bulicp/FRI-ESP32-PCB-workshop/book/src/app-b-01-capacitance.md

# B.1 Capacitance

Match the value called for by the datasheet or your calculation. Going *higher* is usually safe for bulk and decoupling capacitors; going *lower* than a specified value can break stability, as with the LDO in section 2.8.
