bulicp/FRI-ESP32-PCB-workshop/book/src/SUMMARY.md

# Summary

[Introduction](intro.md)

- [0. What we are building](00-what-we-are-building.md)
  - [Signal assignment](00-01-signal-assignment.md)
- [1. Vocabulary](01-vocabulary.md)
- [2. The schematic](02-the-schematic.md)
  - [2.1 What a schematic is, and what it is not](02-01-what-a-schematic-is-and-what-it-is-not.md)
  - [2.2 The power chain](02-02-the-power-chain.md)
  - [2.3 The USB-C receptacle](02-03-the-usb-c-receptacle.md)
  - [2.4 Why the receptacle has D+/D− in two places](02-04-why-the-receptacle-has-d-d-in-two-places.md)
  - [2.5 CC1 / CC2 — why exactly 5.1 kΩ](02-05-cc1-cc2-why-exactly-5-1-k.md)
  - [2.6 ESD protection, twice](02-06-esd-protection-twice.md)
  - [2.7 The LDO regulator](02-07-the-ldo-regulator.md)
  - [2.8 Regulator capacitors — do not improvise these values](02-08-regulator-capacitors-do-not-improvise-these-values.md)
  - [2.9 The module and its decoupling](02-09-the-module-and-its-decoupling.md)
  - [2.10 Buttons, strapping pins and the boot sequence](02-10-buttons-strapping-pins-and-the-boot-sequence.md)
  - [2.11 LEDs and the active-low trap](02-11-leds-and-the-active-low-trap.md)
  - [2.12 Breakout headers, and why the board is not a finished product](02-12-breakout-headers-and-why-the-board-is-not-a-finish.md)
  - [2.13 Schematic grouping and PWR_FLAG](02-13-schematic-grouping-and-pwr-flag.md)
  - [2.14 ERC](02-14-erc.md)
- [3. Footprints and board outline](03-footprints-and-board-outline.md)
  - [3.1 Footprints: where logic meets physics](03-01-footprints-where-logic-meets-physics.md)
  - [3.2 Package families: through-hole and surface mount](03-02-package-families-through-hole-and-surface-mount.md)
  - [3.3 Package sizes: 0402 vs 0603 vs 0805](03-03-package-sizes-0402-vs-0603-vs-0805.md)
  - [3.4 Board outline](03-04-board-outline.md)
- [4. Layers and placement](04-layers-and-placement.md)
  - [4.1 Placement strategy](04-01-placement-strategy.md)
  - [4.2 Why four layers](04-02-why-four-layers.md)
  - [4.3 Two islands on one layer, and zone priority](04-03-two-islands-on-one-layer-and-zone-priority.md)
  - [4.4 Vias: connecting pins, layers and planes](04-04-vias-connecting-pins-layers-and-planes.md)
- [5. Routing](05-routing.md)
  - [5.1 Net classes](05-01-net-classes.md)
  - [5.2 Differential pair routing](05-02-differential-pair-routing.md)
  - [5.3 Routing order](05-03-routing-order.md)
  - [5.4 Pours and stitching vias](05-04-pours-and-stitching-vias.md)
  - [5.5 DRC](05-05-drc.md)
- [6. Manufacturing outputs](06-manufacturing-outputs.md)
  - [6.1 What the fabricator receives](06-01-what-the-fabricator-receives.md)
  - [6.2 Export](06-02-export.md)
  - [6.3 Look at what you are sending](06-03-look-at-what-you-are-sending.md)
  - [6.4 The BOM](06-04-the-bom.md)
  - [6.5 DFM: talking to the fabricator](06-05-dfm-talking-to-the-fabricator.md)
- [7. Bringing the board up](07-bringing-the-board-up.md)
  - [7.1 Before plugging in USB](07-01-before-plugging-in-usb.md)
  - [7.2 Sequence](07-02-sequence.md)
  - [7.3 First program](07-03-first-program.md)
- [Appendix A: Common mistakes](app-a-common-mistakes.md)
- [Appendix B: How to select a capacitor](app-b-how-to-select-a-capacitor.md)
  - [B.1 Capacitance](app-b-01-capacitance.md)
  - [B.2 Voltage rating — and why to derate](app-b-02-voltage-rating-and-why-to-derate.md)
  - [B.3 Dielectric class](app-b-03-dielectric-class.md)
  - [B.4 Checklist before adding a part to the BOM](app-b-04-checklist-before-adding-a-part-to-the-bom.md)
- [Appendix C: Bill of materials](app-c-bill-of-materials.md)
- [Appendix D: Where to go next](app-d-where-to-go-next.md)
- [Appendix E: Reference material](app-e-reference-material.md)
