bulicp/FRI-ESP32-PCB-workshop/book/src/images/esd-protection.png

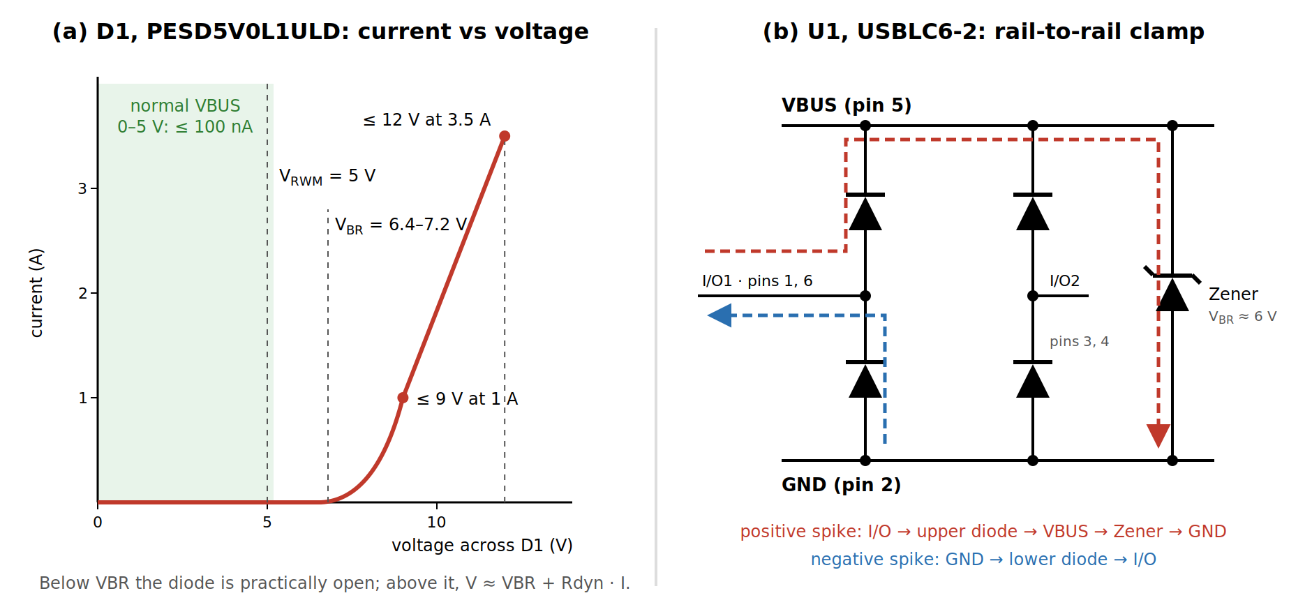
book/src/images/esd-protection.png
