bulicp/FRI-ESP32-PCB-workshop/book/src/images/ldo-block.png

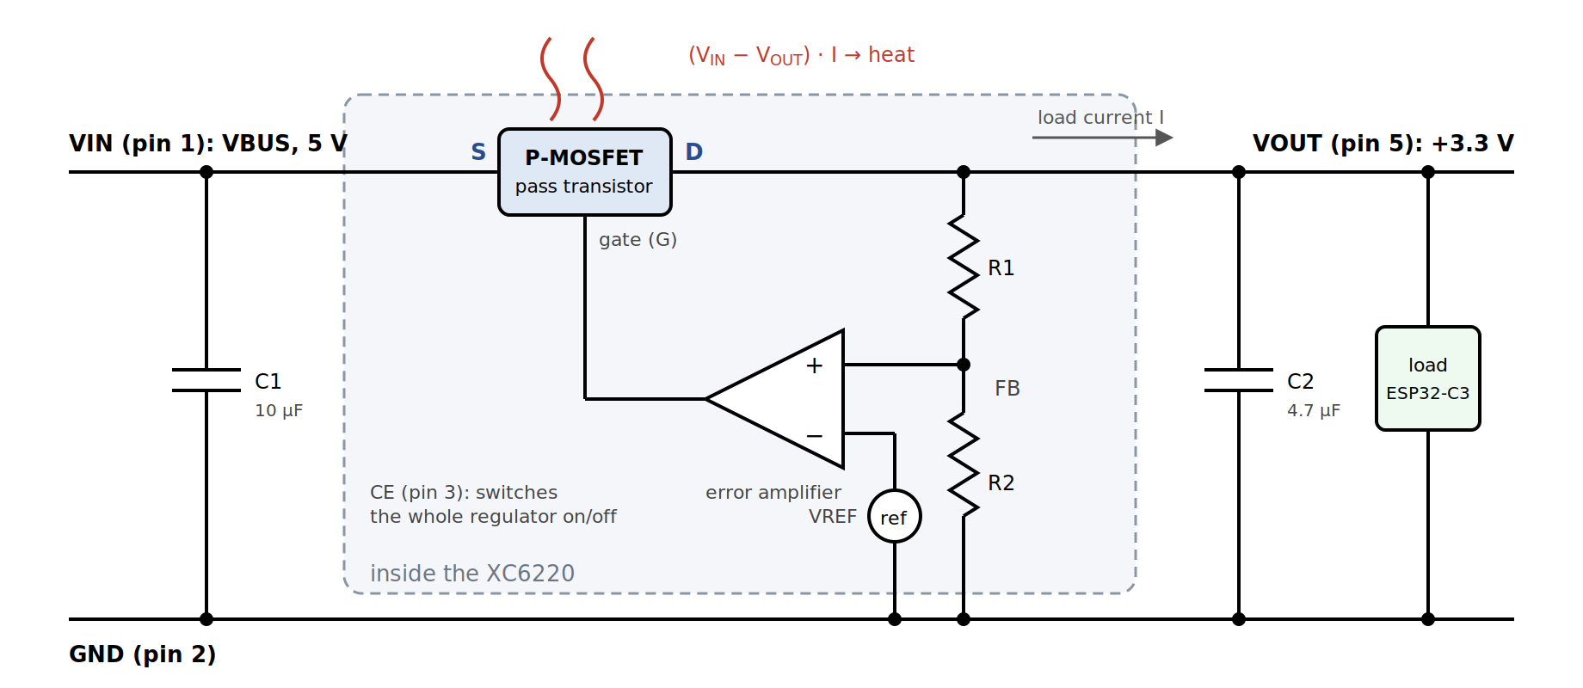
book/src/images/ldo-block.png
