bulicp/FRI-ESP32-PCB-workshop/book/src/images/packages.png

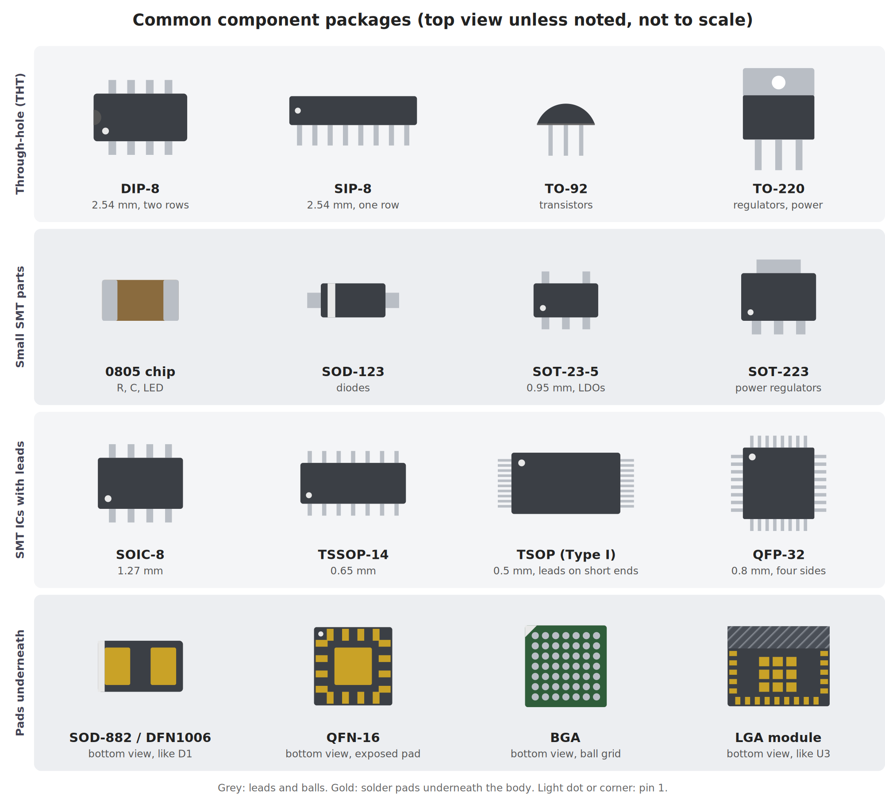
book/src/images/packages.png
