bulicp/FRI-ESP32-PCB-workshop/book/src/images/usb-c-cc-divider 2.png

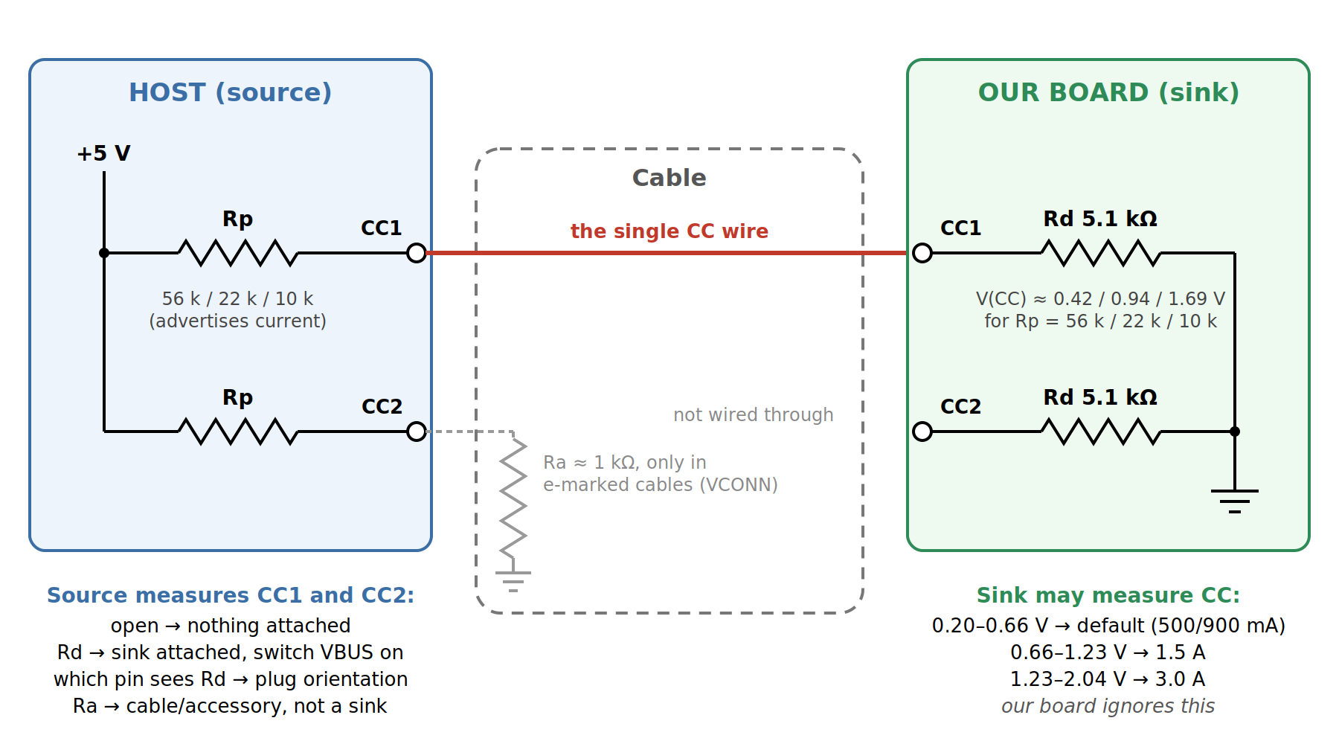
book/src/images/usb-c-cc-divider 2.png
