bulicp/FRI-ESP32-PCB-workshop/book/src/app-b-04-checklist-before-adding-a-part-to-the-bom.md

# B.4 Checklist before adding a part to the BOM

1. Capacitance meets or exceeds the requirement
2. Voltage rating ≥ 2× the working voltage
3. Dielectric is X5R or X7R
4. Package matches the intended assembly method
