bulicp/FRI-ESP32-PCB-workshop/book/src/app-e-reference-material.md

# Appendix E: Reference material

| Document | Source |
|---|---|
| ESP32-C3-MINI-1 & MINI-1U Datasheet v2.2 | Espressif — pinout, boot configuration, land pattern |
| ESP32-C3 Technical Reference Manual | Espressif |
| ESP Hardware Design Guidelines — PCB Layout | Espressif — stackup and power-plane principles |
| XC6220 series datasheet | Torex — the C<sub>IN</sub>/C<sub>L</sub> compensation table |
| USBLC6-2SC6 datasheet | STMicroelectronics |
| PESD5V0L1ULD datasheet | Nexperia |
| KiCad documentation | docs.kicad.org |
