bulicp/FRI-ESP32-PCB-workshop/book/src/app-b-how-to-select-a-capacitor.md

# Appendix B: How to select a capacitor

Beyond the nominal value, three parameters matter.
