bulicp/FRI-ESP32-PCB-workshop/03-powerzones/FRI-ESP32.kicad_pcb

## KiCad design 03-powerzones/FRI-ESP32.kicad_pcb (2026-09-26)

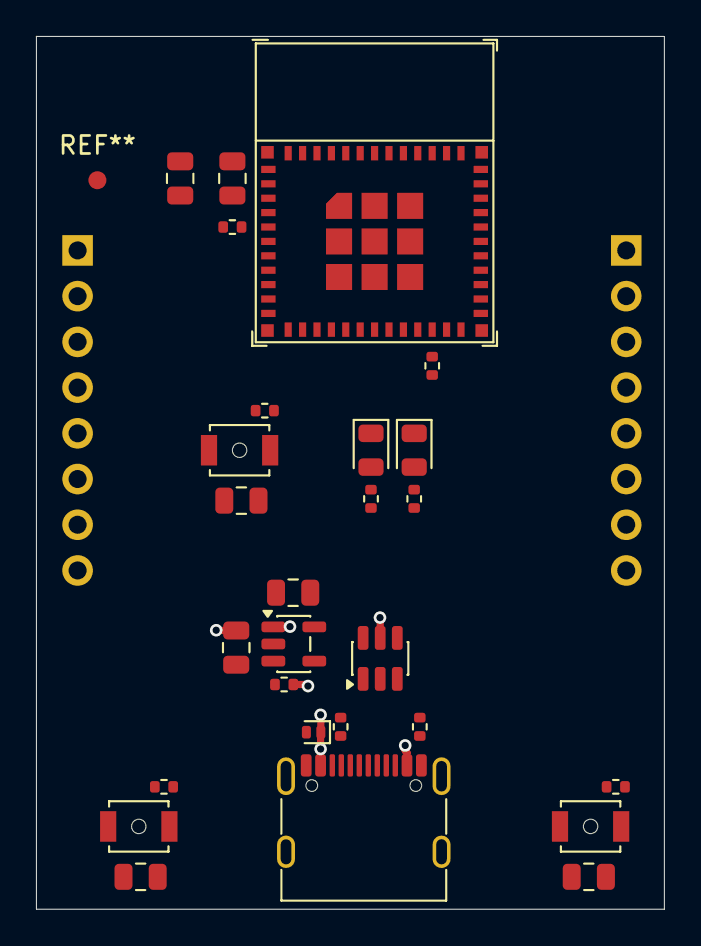
[picture p24: board 03-powerzones/FRI-ESP32.kicad_pcb from above]

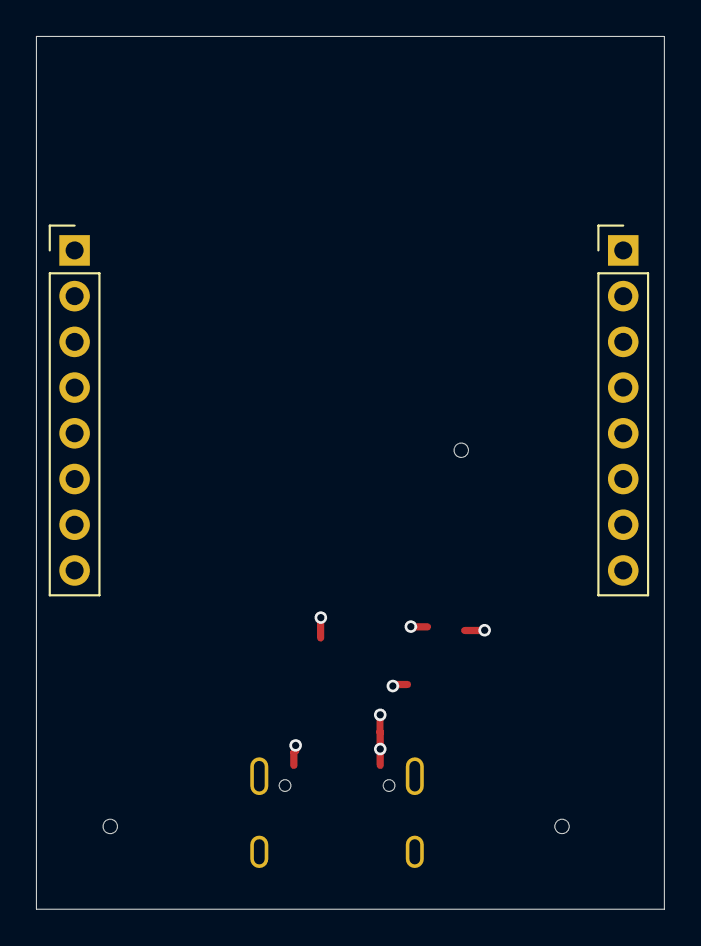
[picture p25: board 03-powerzones/FRI-ESP32.kicad_pcb from below]

Board: 4 copper layers, 34.9 x 48.5 mm, 29 parts (2 on the bottom side), 26 nets.

Parts:
BOOT1: SW_Push; SW_SPST_B3U-1000P-B
C1, C7: 10uF; C_0805_2012Metric
C2: 4.7uF; C_0805_2012Metric
C3, C4, C5, C6: 100nF; C_0805_2012Metric
D1: PESD5V0L1ULD; D_SOD-882D
D2: LED GREEN; LED_0805_2012Metric
D3: LED YELLOW; LED_0805_2012Metric
J1: USB_C_Receptacle_USB2.0_16P; USB_C_Receptacle_G-Switch_GT-USB-7010ASV
J2, J3: Conn_01x08; PinHeader_1x08_P2.54mm_Vertical
R1, R2: 5.1K; R_0402_1005Metric
R3: 4.7K; R_0402_1005Metric
R4, R5, R6, R7, R8: 10K; R_0402_1005Metric
R9, R10: 330R; R_0402_1005Metric
RESET1: SW_Push; SW_SPST_B3U-1000P-B
U1: USBLC6-2SC6; SOT-23-6
U2: XC6220B331MR; SOT-23-5
U3: ESP32-C3-MINI-1
USER1: SW_Push; SW_SPST_B3U-1000P-B

Connections:
+3.3V: C2.1, C6.1, C7.1, J2.1, J2.8, R4.1, R5.1, R6.1, R7.1, R8.1, R9.1, R10.1, U2.5 (VOUT), U3.3 (3V3)
/Power/D+: J1.A6 (D+), J1.B6 (D+), U1.3 (I/O2)
/Power/D-: J1.A7 (D-), J1.B7 (D-), U1.1 (I/O1)
EN: C3.1, R4.2, RESET1.2, U3.8 (EN/CHIP_PU)
GND: BOOT1.1, C1.2, C2.2, C3.2, C4.2, C5.2, C6.2, C7.2, D1.2 (A), J1.A1 (GND), J1.A12 (GND), J1.B1 (GND), J1.B12 (GND), J1.SH (SHIELD), J2.5, J2.6, J3.3, R1.2, R2.2, RESET1.1, U1.2 (GND), U2.2 (GND), U3.1 (GND), U3.2 (GND), U3.11 (GND), U3.14 (GND), U3.36 (GND), U3.37 (GND), U3.38 (GND), U3.39 (GND), U3.40 (GND), U3.41 (GND), U3.42 (GND), U3.43 (GND), U3.44 (GND), U3.45 (GND), U3.46 (GND), U3.47 (GND), U3.48 (GND), U3.49 (GND), U3.50 (GND), U3.51 (GND), U3.52 (GND), U3.53 (GND), USER1.1
GPIO0: J3.8, U3.12 (GPIO0/ADC1_CH0/XTAL_32K_P)
GPIO1: J3.7, U3.13 (GPIO1/ADC1_CH1/XTAL_32K_N)
GPIO2_BOOT: R6.2, U3.5 (GPIO2/ADC1_CH2)
GPIO3: J3.6, U3.6 (GPIO3/ADC1_CH3)
GPIO4: J3.5, U3.18 (GPIO4/ADC1_CH4)
GPIO5: J3.4, U3.19 (GPIO5/ADC2_CH0)
GPIO8_BOOT: R7.2, U3.22 (GPIO8)
GPIO9_BOOT: BOOT1.2, C4.1, R5.2, U3.23 (GPIO9)
LED0: D2.1 (K), U3.20 (GPIO6)
LED1: D3.1 (K), U3.21 (GPIO7)
unnamed: D2.2 (A), R9.2
unnamed: D3.2 (A), R10.2
unnamed: J1.A5 (CC1), R2.1
unnamed: J1.B5 (CC2), R1.1
unnamed: R3.1, U2.3 (CE)
RXD0: J3.2, U3.30 (GPIO20/U0RXD)
TXD0: J3.1, U3.31 (GPIO21/U0TXD)
USB_D+: U1.4 (I/O2), U3.27 (GPIO19/USB_D+)
USB_D-: U1.6 (I/O1), U3.26 (GPIO18/USB_D-)
USER_BTN: C5.1, R8.2, U3.16 (GPIO10), USER1.2
VBUS: C1.1, D1.1 (K), J1.A4 (VBUS), J1.A9 (VBUS), J1.B4 (VBUS), J1.B9 (VBUS), J2.3, J2.4, R3.2, U1.5 (VBUS), U2.1 (VIN)
