bulicp/FRI-ESP32-PCB-workshop/(commit log)

2026-09-24 Popravljam sedkcije in dodajam slike z handbook
    [ESP32-C3-MINI-1.STEP, FRI-ESP32.kicad_pcb, FRI-ESP32.kicad_sch, digital.kicad_sch, power.kicad_sch]
2026-09-30 Dodam skripto za export
    [FRI-ESP32-B_Cu.gbr, FRI-ESP32-B_Mask.gbr, FRI-ESP32-B_Paste.gbr, FRI-ESP32-B_Silkscreen.gbr, FRI-ESP32-Edge_Cuts.gbr, FRI-ESP32-F_Cu.gbr, FRI-ESP32-F_Mask.gbr, FRI-ESP32-F_Paste.gbr]
